umorena/Mastermind/README.md

# Mastermind
<h2>PROJET ARDUINO - MASTERMIND</h2>

Gubeno Manon - PeiP2 Groupe 2
Morena Ugo - PeiP2 Groupe 2

<h3>Description générale :</h3>

<b>Idée principale :</b> Reprendre le concept du jeu Mastermind sous une forme électronique à l’aide d’Arduino. 

Notre idée de base est d’avoir une caisse (en bois) laquelle laisserait apparaître l’interface du jeu (rubans de LED pour les combinaisons de couleur choisies par le jouer, signaux lumineux pour indiquer le nombre de bonnes et mauvaises réponses etc..)

**Caisse / Support :**

Version finale : en bois, avec plaques de PVC recouvrant les LEDS

La boîte laissera apparaître toutes les LEDS et les boutons de choix des couleurs
Ajout d’une petite trappe qui s’ouvre lorsque le joueur trouve la bonne combinaison de couleur pour laisser apparaître la solution de la partie.

Deux types de parties :

-	Solution choisie par un autre joueur (duo)
-	Solution déterminée aléatoirement (solo)
 
Deux types de mode de jeu :

-	Utilisation des boutons matériels situés sur la boîte
-	Choix des couleurs sur smartphone 

Lancement d’une nouvelle partie : Interrupteur (pour allumer le mastermind)
Choix du nombre de joueurs/type de parties : Interrupteur
Recommencer la partie : bouton matériel

### Sitographie : 

https://www.instructables.com/id/Mastermind-Game-w-Arduino-Uno/
https://forum.arduino.cc/index.php?topic=79978.0
https://www.instructables.com/id/Arduino-Mastermind-Box-Prototype/
