umorena/Mastermind/Rapports_Séances/Gubeno_Manon/Gubeno-5_rapport.pdf

MANON GUBENO
03/02/20

## MASTERMIND ARDUINO

RAPPORT DE SÉANCE : Semaine du 3 février

Objectif de la séance :

- Soudures LEDs

1 ) SOUDURE DES LEDS

La séance d’aujourd’hui a uniquement servi à continuer les soudures des bandes de LEDs. Notre projet est constitué de deux serpentins de LEDS (contenant chacun 48 LEDs) soit de 96 LEDs mise en « serpentins ». Pour avoir une telle organisation il a fallu souder entre elles les bandes de LEDs :

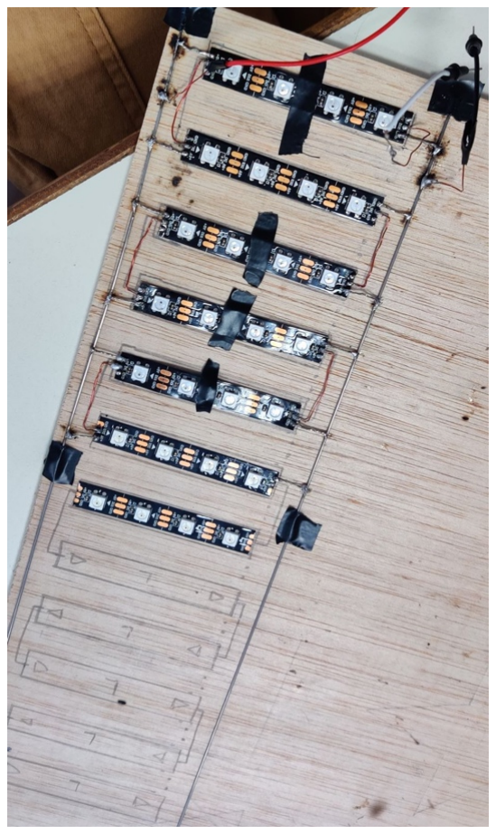
[picture p27: figure]
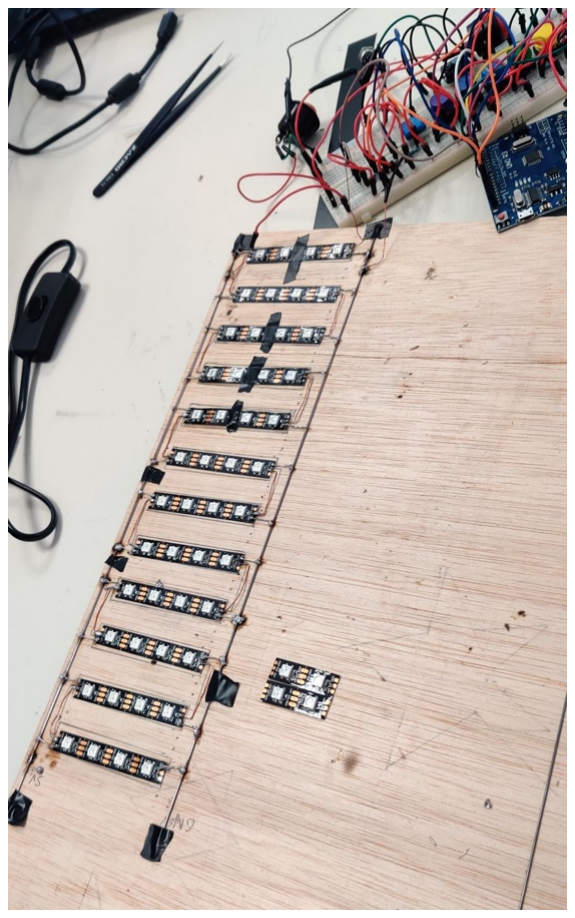
[picture p28: figure]

Le processus a pris beaucoup de temps car il fallait relier chaque bande de LEDs aux câbles 5V et GND, il fallait également relier toutes les bandes de LEDs entre elles.

A chaque bande rajouté il faut vérifier le bon fonctionnement de chacune des LEDs :

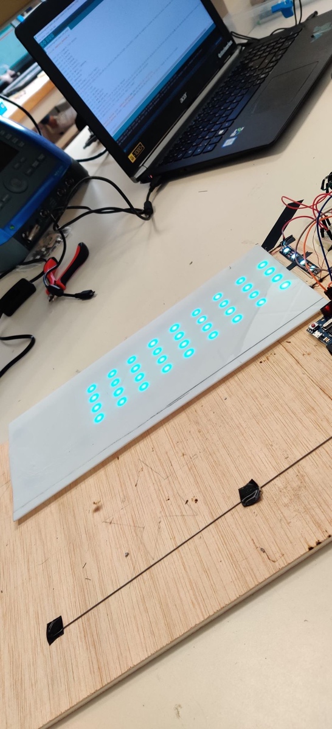
[picture p29: figure]
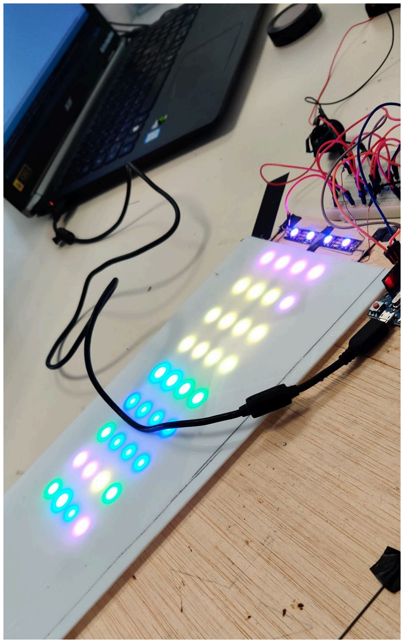
[picture p30: figure]
