umorena/Mastermind/Rapports_Séances/Gubeno_Manon/Gubeno-4_rapport.pdf

MANON GUBENO
13/01/20

## MASTERMIND ARDUINO

RAPPORT DE SÉANCE : Semaine de 13 janvier 2020

Objectif de la séance :

- Soudure LEDs
- ServoMoteur

1 ) SOUDURE LEDS

Notre projet est composé essentiellement de LED (en tout : (4*12)+(4*12)+4 = 100 LEDs) Pour minimiser les branchements et l’utilisation des ports on utilise des rubans de LEDs Neopixels.
On réalise deux serpentins de LEDs : pour se faire on doit souder des portions de LEDs et tester les raccords à chaque soudure réalisée.

Le processus est assez long car après chaque soudure on doit vérifier que tout fonctionne bien. On utilise le programme pour tester les lumières RGB de chaque LEDs et on l’applique à chaque bout de bande de LEDs soudé.

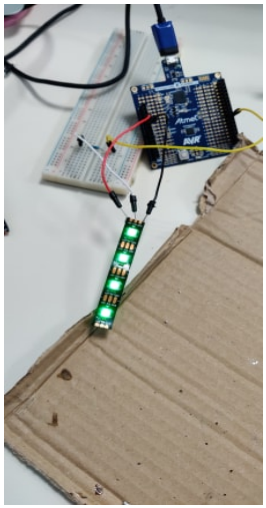
[picture p31: figure]
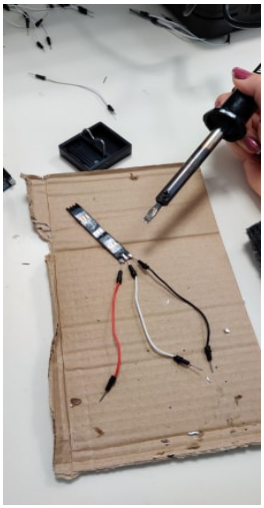
[picture p32: figure]

2) SERVOMOTEUR

Pour ouvrir la trappe qui dévoile la solution finale, on cherchait un moteur qui puisse se déclencher lorsque l’utilisateur trouvait la bonne réponse ou bien en cas d’échec.
Pour cela on utilise un ServoMoteur. Puisque c’était la première fois que j’utilisais un Servo moteur j’ai du chercher des tutoriels sur internet pour comprendre comment le brancher et comment le programmer.

Branchement du ServoMoteur :

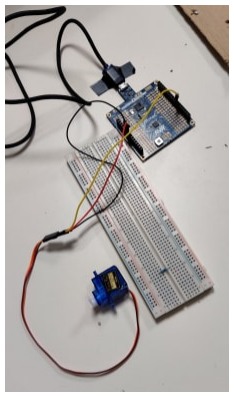
[picture p33: figure]
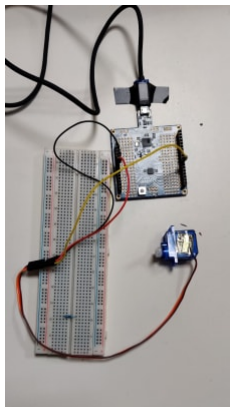
[picture p34: figure]

puis on réalise un code test pour vérifier qu’il fonctionne bien :

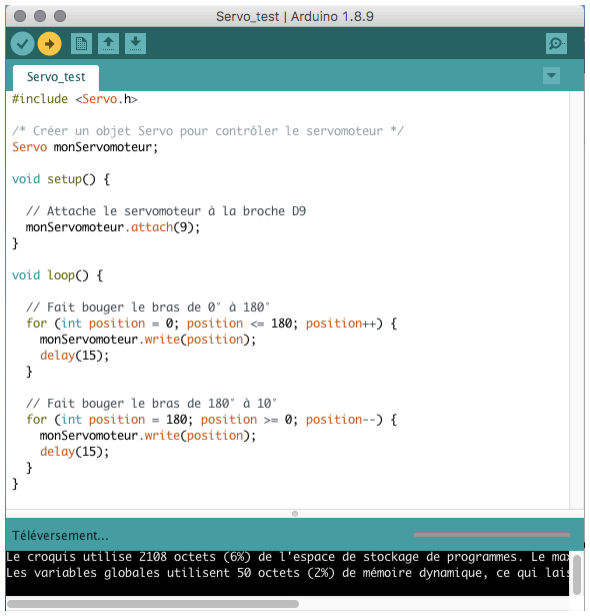
[picture p35: figure]

Le code permet au servomoteur d’effectuer des va-et-viens : on vérifie ainsi qu’il fonctionne bien.

On applique maintenant l’utilisation du servo-moteur à notre projet. Le but est d’effectuer un angle de 180° lorsque l’utilisateur trouve la bonne réponse ou lorsque la partie est finie.
