umorena/Mastermind/Rapports_Séances/Gubeno_Manon/Gubeno-2_rapport.pdf

MANON GUBENO
16/12/19

## MASTERMIND ARDUINO

RAPPORT DE SÉANCE : Semaine de 16 décembre

Objectif de la séance :

- Finir programme bande de LEDS
- Liaison bouton/LEDS

1 ) PROGRAMMER BANDES DE LEDS

À la dernière séance, j’ai essayé de comprendre comment fonctionnait les bandes LEDS et comment les programmer.
J’ai commencé par télécharger la bibliothèque FastLEDS et fais quelques tests peu concluants : seule la première LED s’allumait.

Solution possible : changer de bibliothèque ?

Après l’aide de Mr. MASSON, on télécharge la bibliothèque Adafruit_NeoPixel. On teste d’abord les LEDs pour être sûr qu’elles fonctionnent toutes avec un programme test (celui envoyé dans le mail de réponse) qui permet d’allumer toutes les LEDS dans les tons rouges, verts et enfin bleu afin de vérifier que toutes sont fonctionnelles et dans les trois teintes RGB

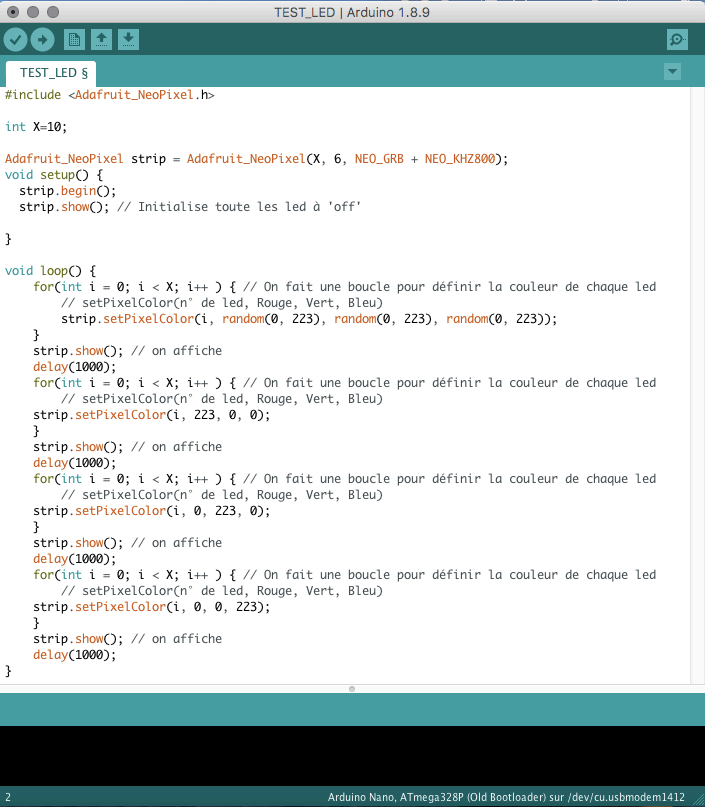
[picture p48: figure]

On utilise le programme pour tester les différentes bandes de LEDs que l’on a récupéré pour notre projet :

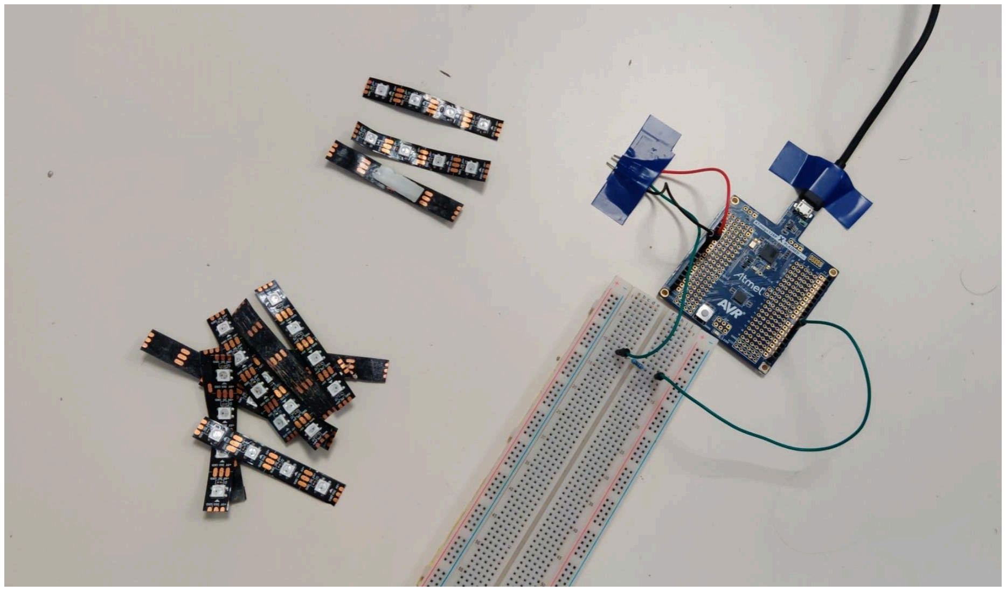
[picture p49: figure]

On vérifie que toutes les LEDs s’allument et que leur couleurs RGB ressortent bien :

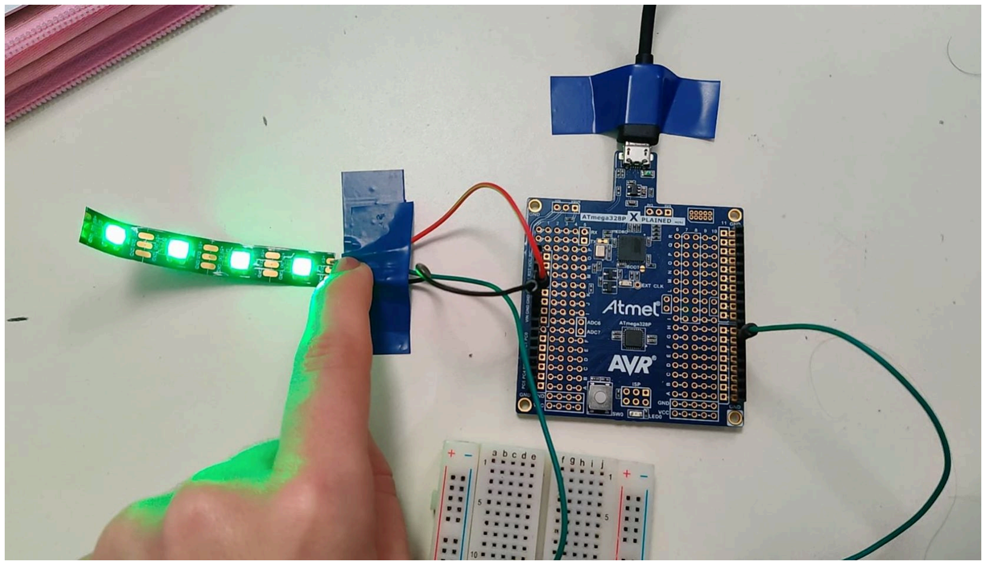
[picture p50: figure]
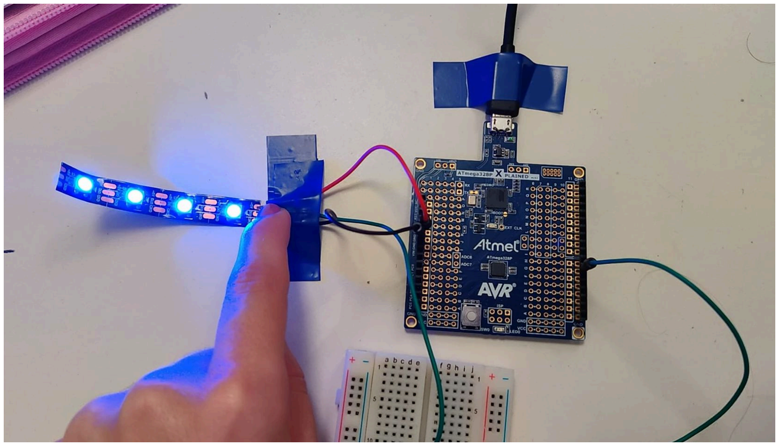
[picture p51: figure]
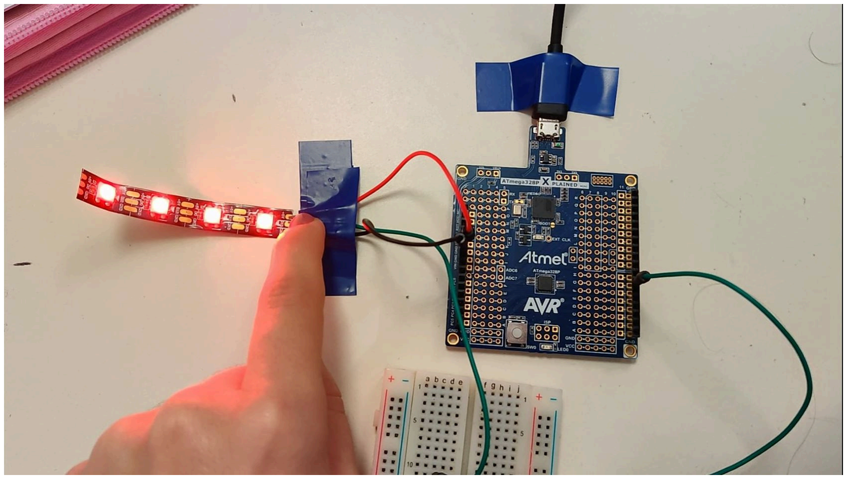
[picture p52: figure]

Après avoir vérifié le fonctionnement de chacune des LEDs, on réalise un code test permettant de tester l’allumage des LEDS dans des couleurs deux à deux différentes : (test réalisé sur des bandes de 4 LEDs)

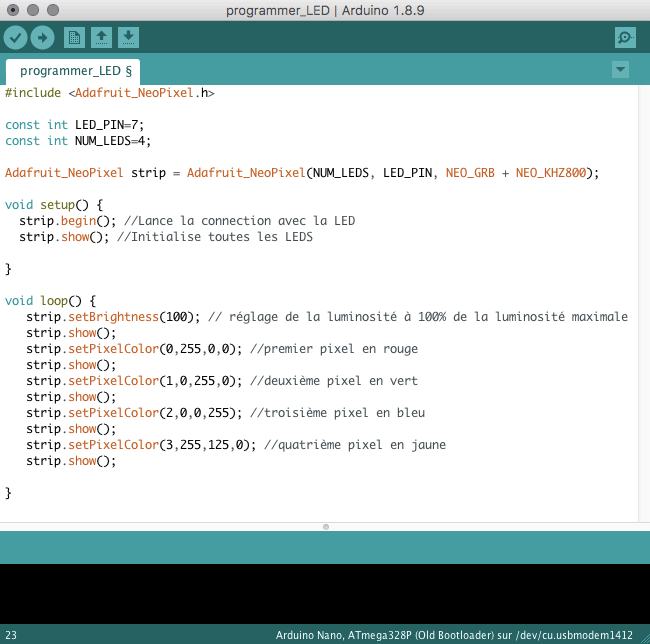
[picture p53: figure]
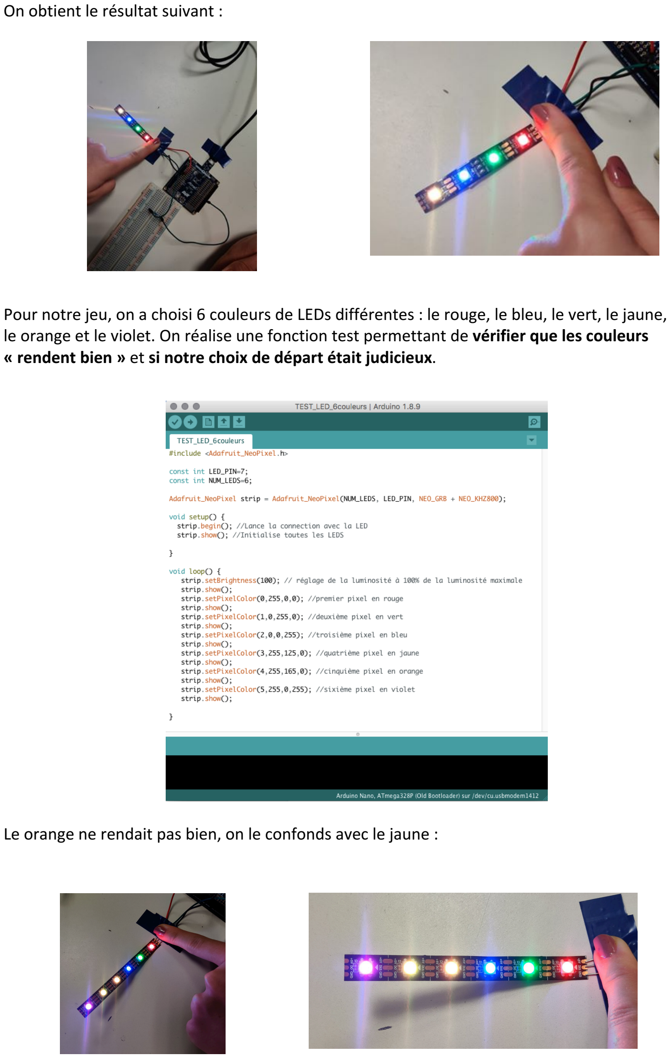
[picture p54: page 3]

On obtient le résultat suivant :

Pour notre jeu, on a choisi 6 couleurs de LEDs différentes : le rouge, le bleu, le vert, le jaune, le orange et le violet. On réalise une fonction test permettant de vérifier que les couleurs « rendent bien » et si notre choix de départ était judicieux.

Le orange ne rendait pas bien, on le confonds avec le jaune :

On réalise plusieurs test :

- Le rose → se confond avec le violet
- Le marron → se confond avec le rouge
- Le turquoise ✓

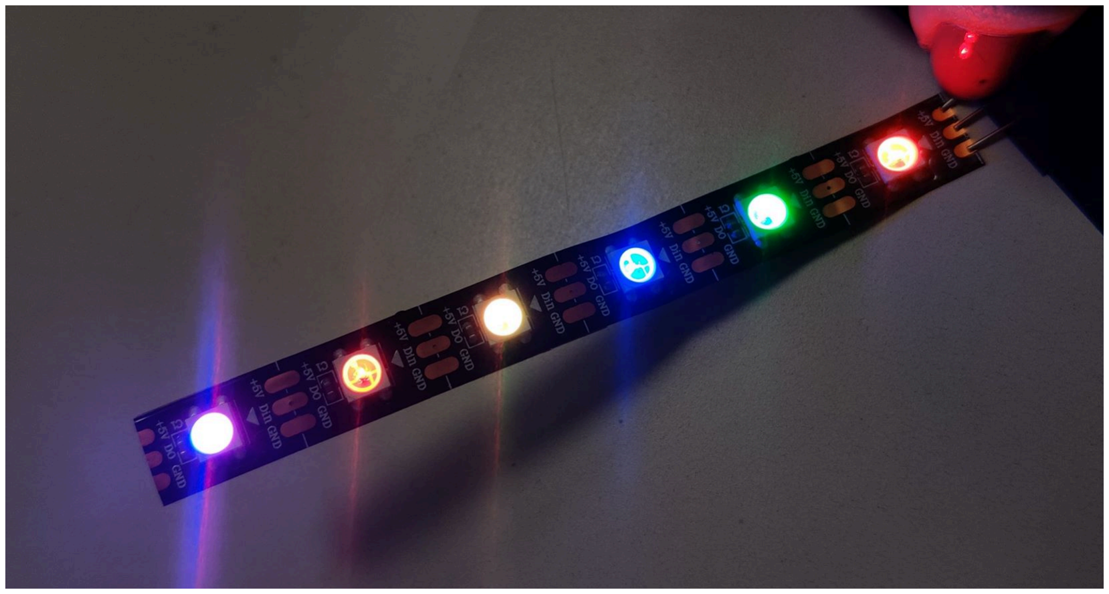
[picture p55: figure]
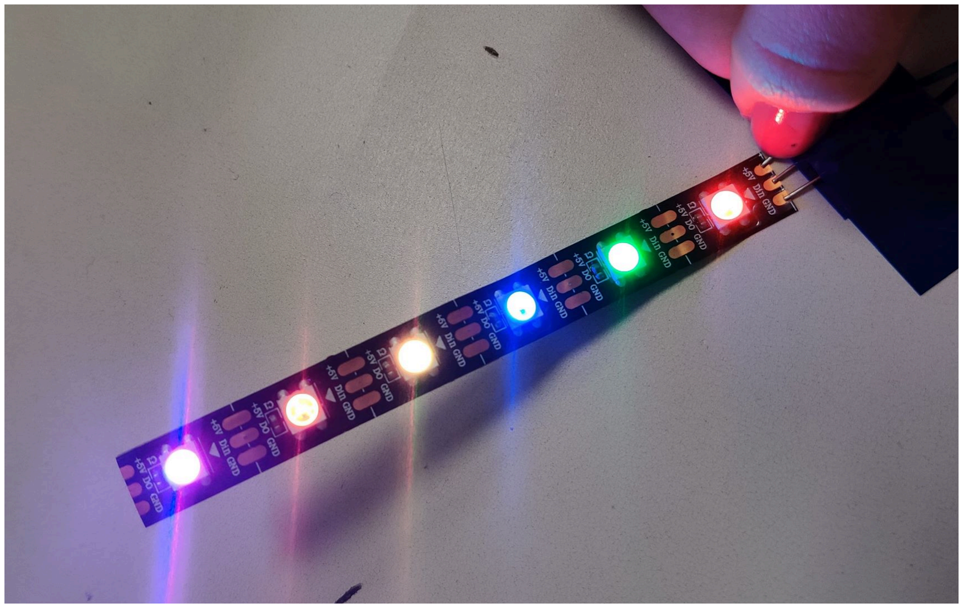
[picture p56: figure]
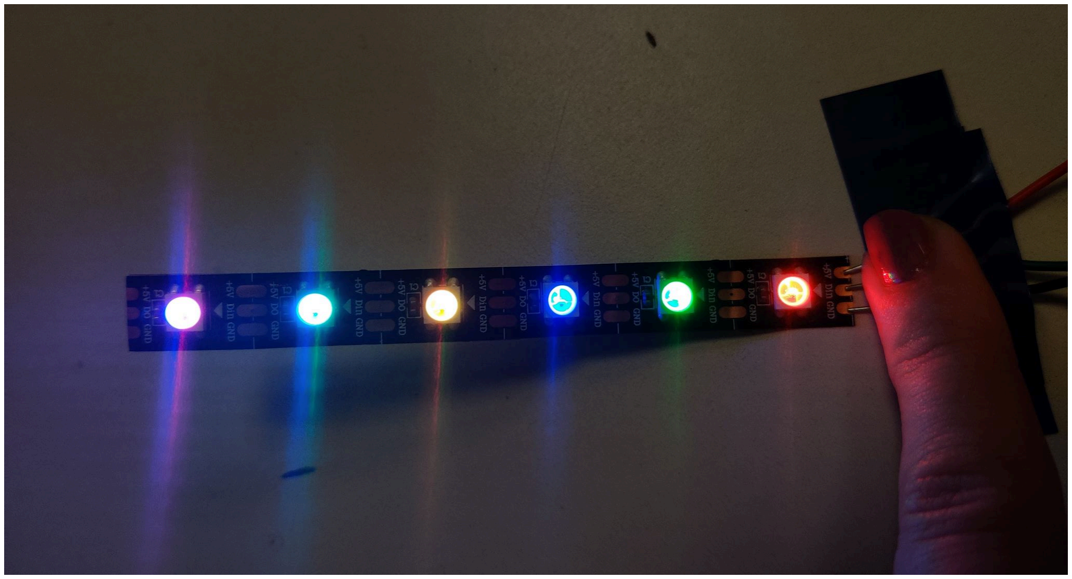
[picture p57: figure]

2) LIAISON BOUTON/LEDS

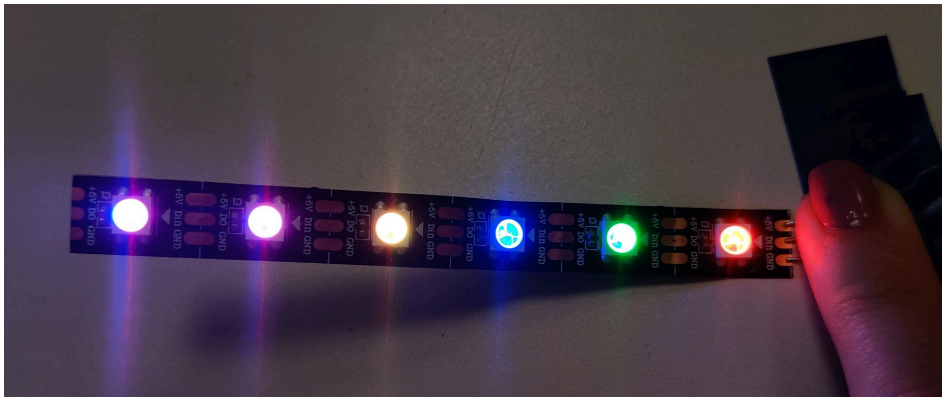
[picture p58: figure]
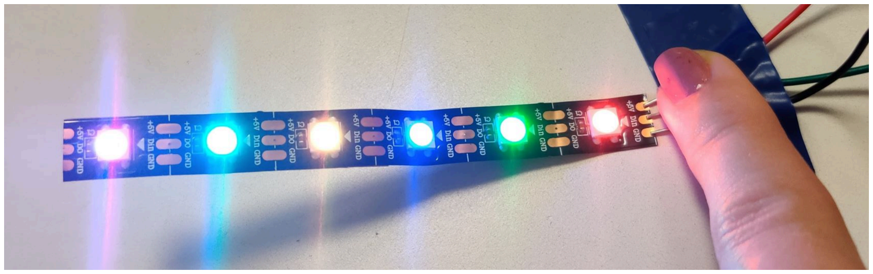
[picture p59: figure]

On cherche maintenant à lier l’action du bouton avec l’allumage des LEDs.
On a à notre disposition 6 boutons de couleurs, le but est :

Lorsque l’utilisateur appuie sur le bouton rouge, la première LED s’allume en rouge,
S’il appuie ensuite sur le bouton vert, la deuxième LED s’allume en vert (tout en conservant la première LED colorée en rouge),
S’il appuie ensuite sur le bouton vert, la troisième LED s’allume en violet (tout en conservant la couleur des 2 premières LEDs),
etc..

Au bout de la 4ème LED (extremité d’une ligne), le premier essai est terminé et il passe au second → première LED de la deuxième ligne

Et ainsi de suite !

Simulation pour essayer d’appréhender au mieux le programme à écrire : (l’éclair représente l’action d’appuyer sur un bouton)

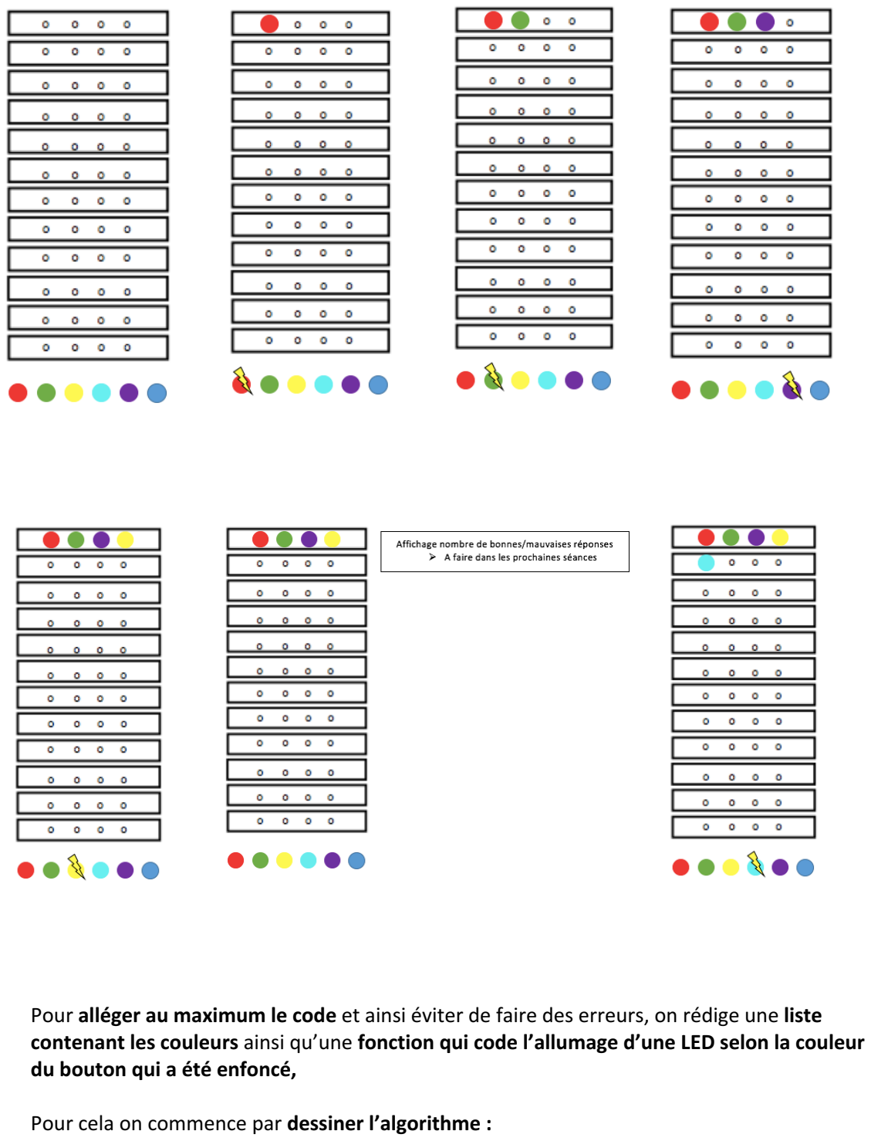
[picture p60: page 5]

Pour alléger au maximum le code et ainsi éviter de faire des erreurs, on rédige une liste contenant les couleurs ainsi qu’une fonction qui code l’allumage d’une LED selon la couleur du bouton qui a été enfoncé,

Pour cela on commence par dessiner l’algorithme :

La couleur d'une LED se définit sous 4 variables :

- sa position sur la bande (de 0 à 48)
- son pourcentage en rouge
- son pourcentage en vert
- son pourcentage de bleu

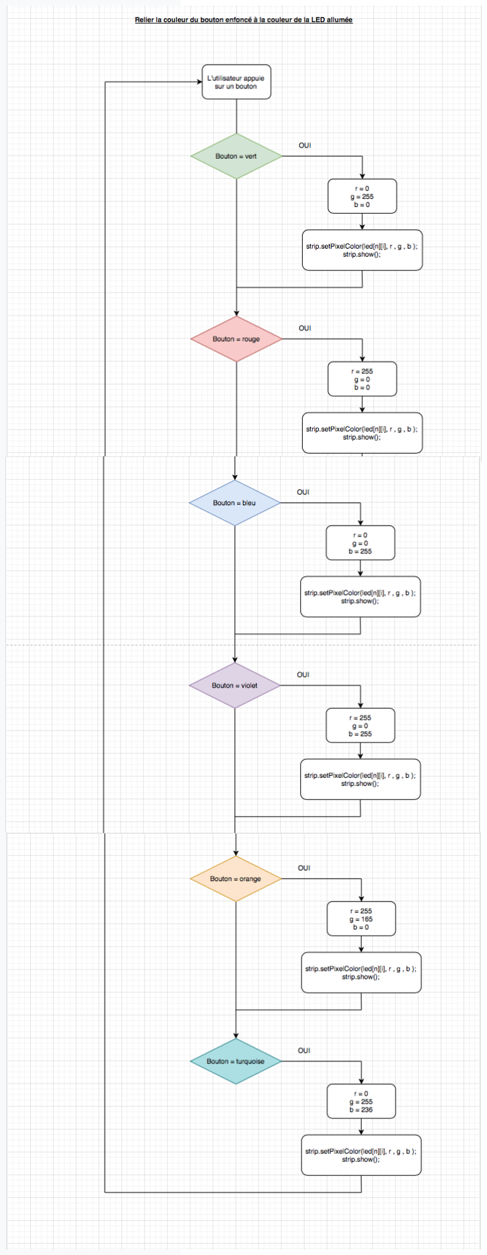
[picture p61: figure]
