umorena/Mastermind/Rapports_Séances/Morena_Ugo/Morena-8_rapport.pdf

Ugo Morena G2
RAPPORT SÉANCE 2 MARS 2020

Objectif de la séance :

- Fignoler des détails de code
- Continuer l'assemblage de la boite
- Avancer / finir le bluetooth (avec Manon)

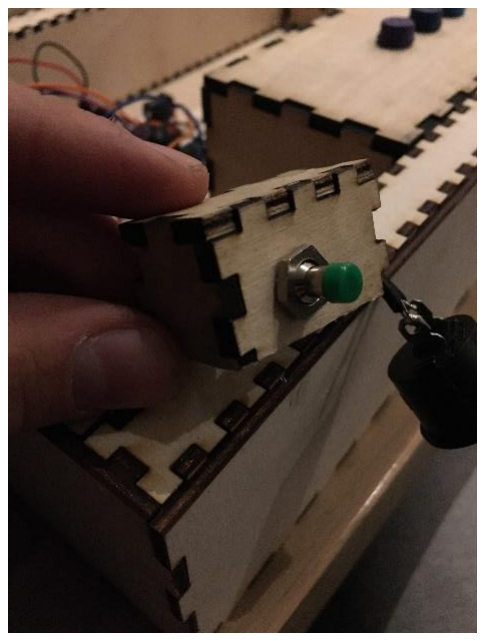
[picture p97: figure]
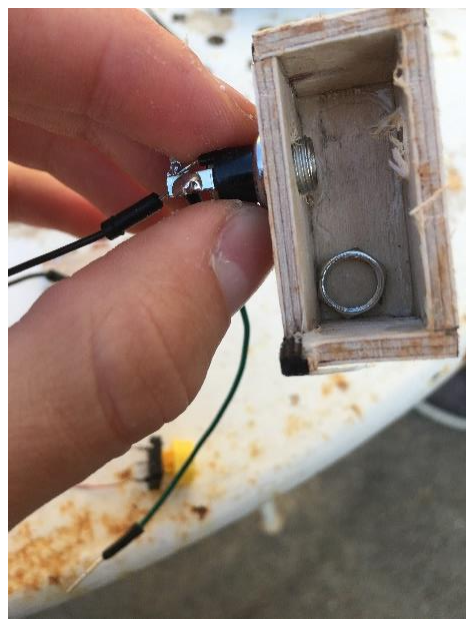
[picture p98: figure]

Travail réalisé avant la séance :

Avancement de la boîte en bois :

Idée de base pour l'attache des boutons

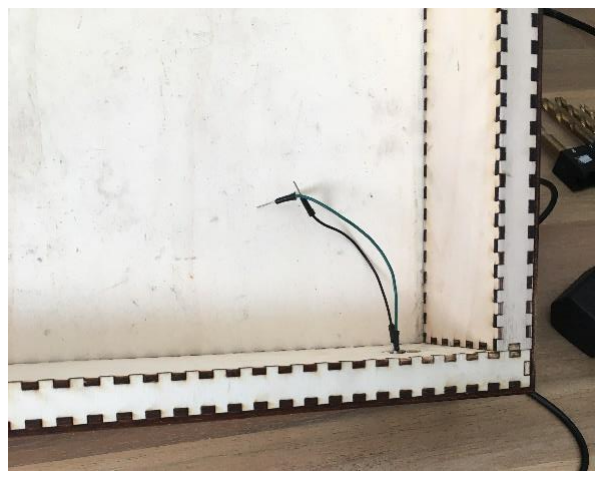
[picture p99: figure]
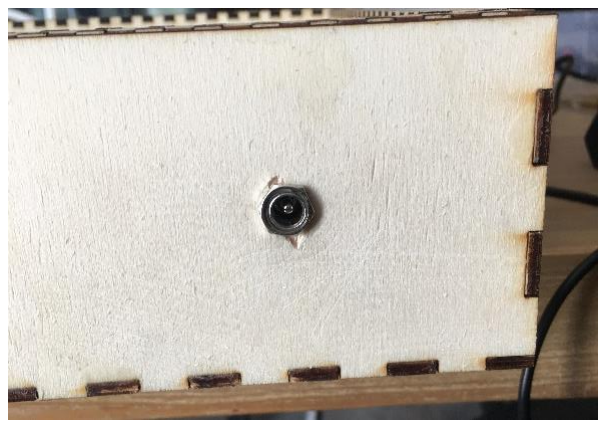
[picture p100: figure]
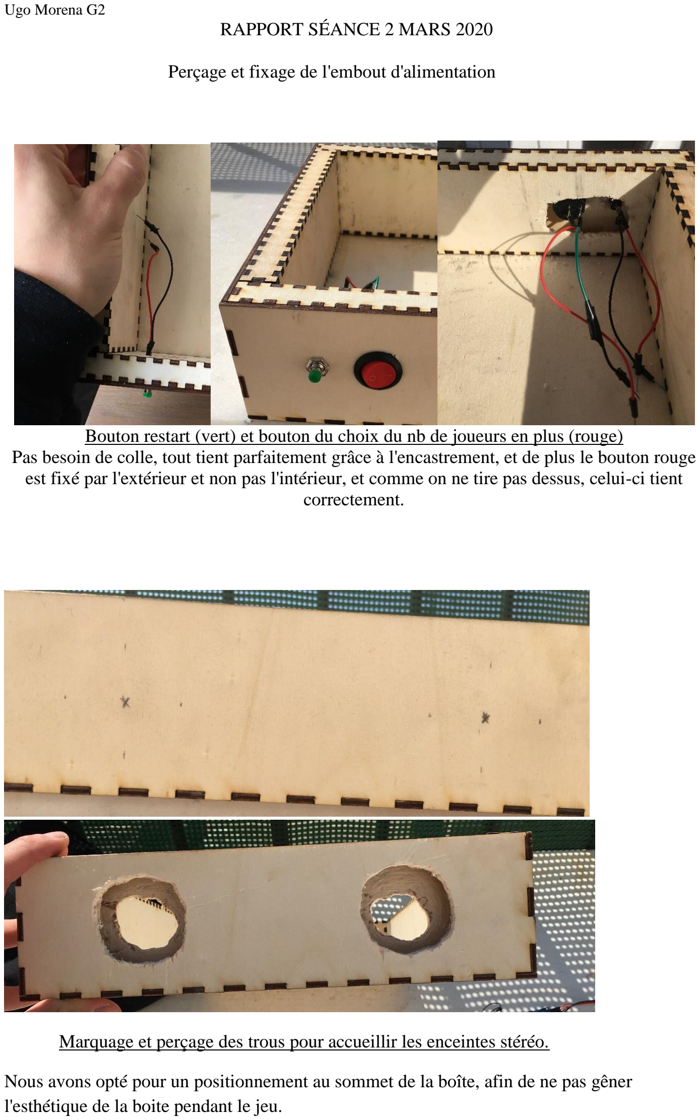
[picture p101: page 2]

Perçage et fixage de l'embout d'alimentation

Bouton restart (vert) et bouton du choix du nb de joueurs en plus (rouge)
Pas besoin de colle, tout tient parfaitement grâce à l'encastrement, et de plus le bouton rouge est fixé par l'extérieur et non pas l'intérieur, et comme on ne tire pas dessus, celui-ci tient correctement.

Marquage et perçage des trous pour accueillir les enceintes stéréo.

Nous avons opté pour un positionnement au sommet de la boîte, afin de ne pas gêner l'esthétique de la boite pendant le jeu.

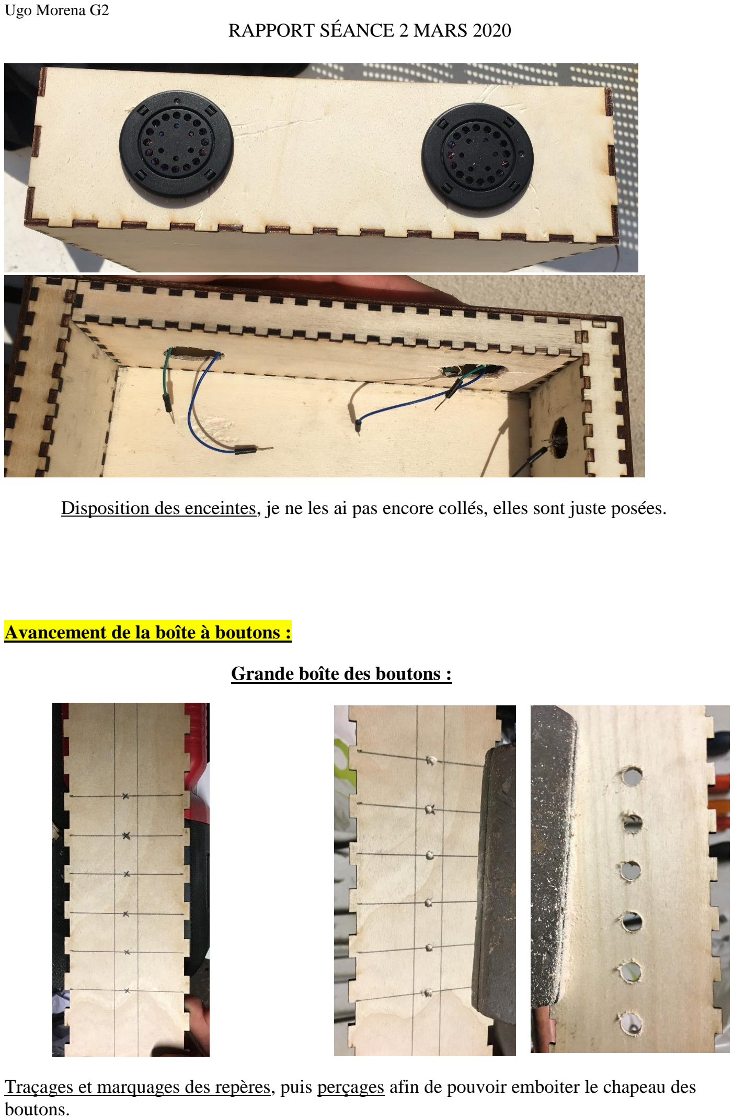
[picture p102: page 3]

Disposition des enceintes, je ne les ai pas encore collés, elles sont juste posées.

Avancement de la boîte à boutons :

Grande boîte des boutons :

Traçages et marquages des repères, puis perçages afin de pouvoir emboiter le chapeau des boutons.

Petite boîte des boutons :

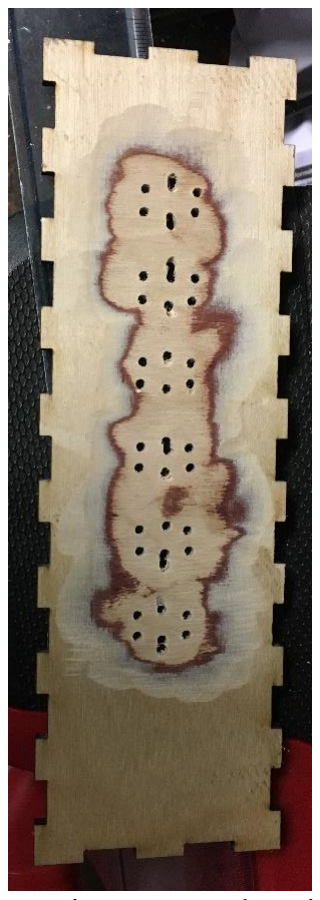
[picture p103: figure]
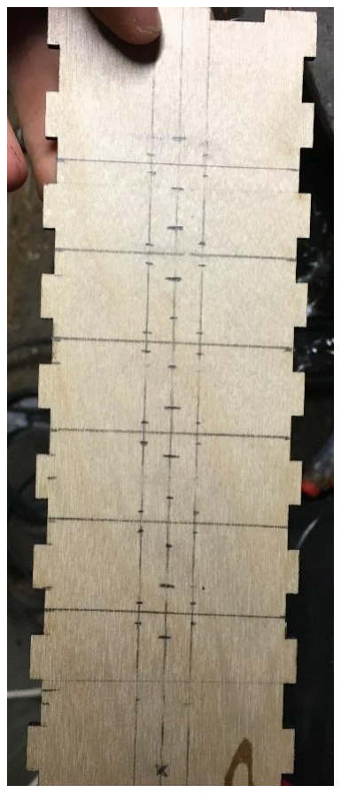
[picture p104: figure]

Traçage et marquage des repères, puis perçages pour venir encastrer les pins des boutons Enfin, ponçage afin de réduire l'épaisseur et permettre un écart plus faible pour que les boutons puissent être correctement pressés.

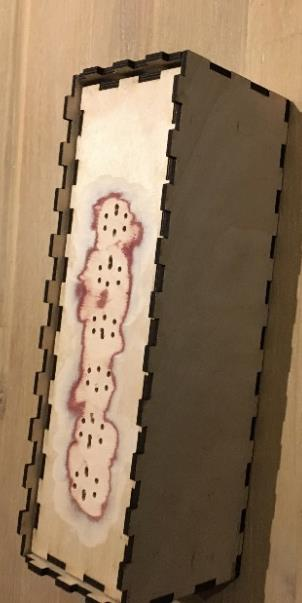
[picture p105: figure]
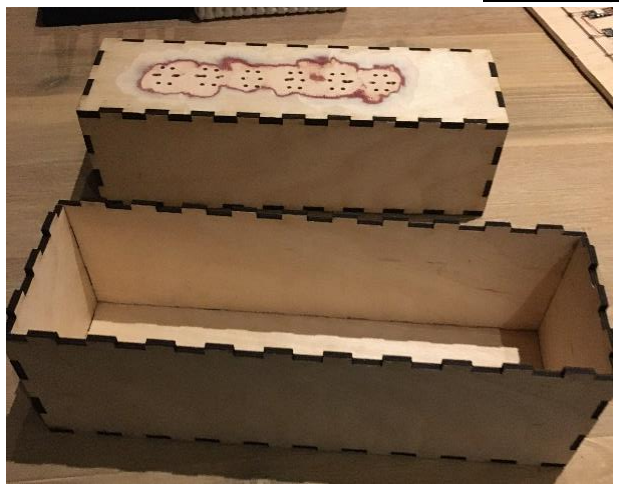
[picture p106: figure]

Assemblage :

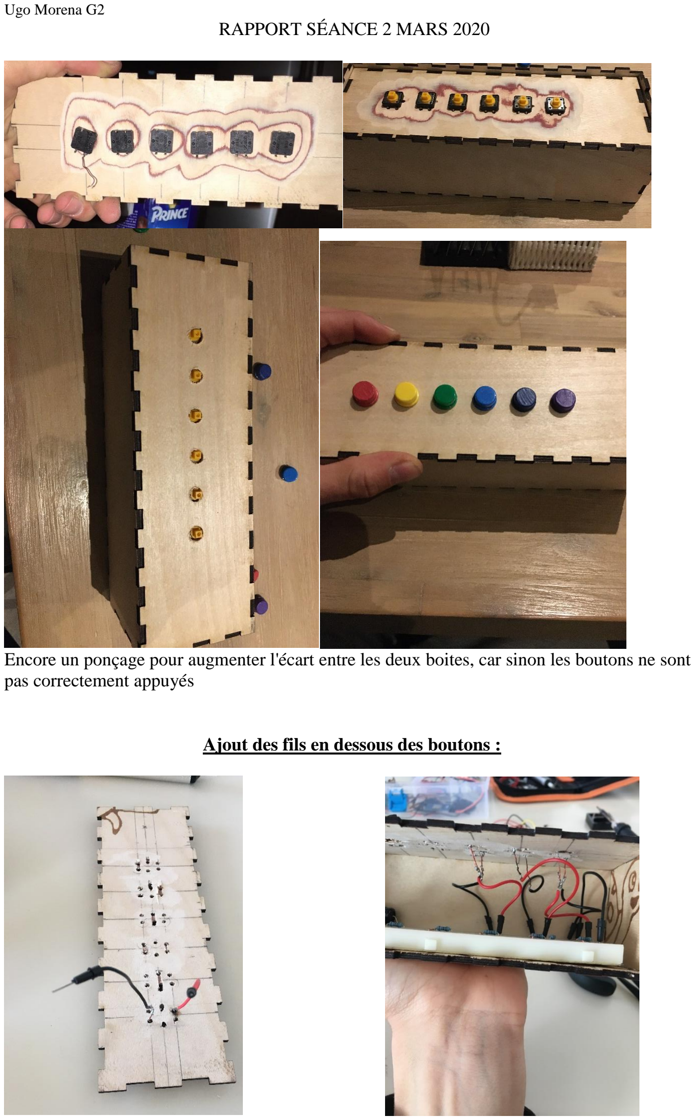
[picture p107: page 5]

Encore un ponçage pour augmenter l'écart entre les deux boites, car sinon les boutons ne sont pas correctement appuyés

Ajout des fils en dessous des boutons :

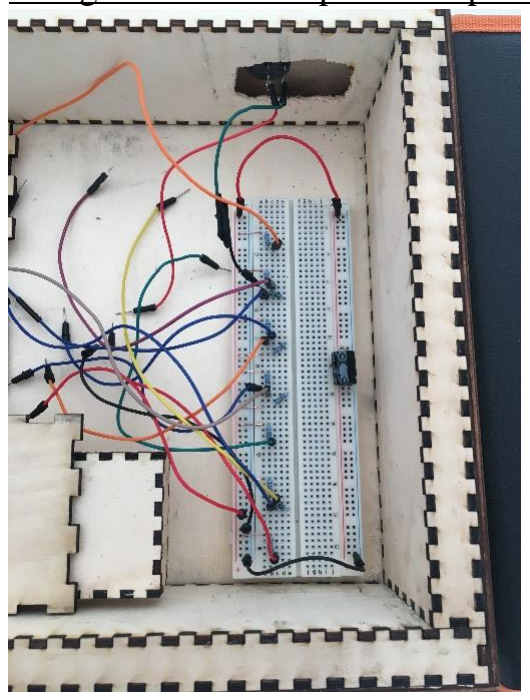
[picture p108: figure]

Réorganisation de la planche à pain, et traçage des traits de découpe sur les faces de la boite.

Travail réalisé durant la séance :

J'ai changé le bouton restart et undo car ceux-ci s'étaient cassés. Ensuite, j'ai continué les soudures pour les câblages des boutons, ce qui m'a pris un certain temps.
J'ai inséré la boite des boutons dans la boite du Mastermind, pour pouvoir ensuite brancher la planche au reste de l'arduino, ce qui est très minutieux.

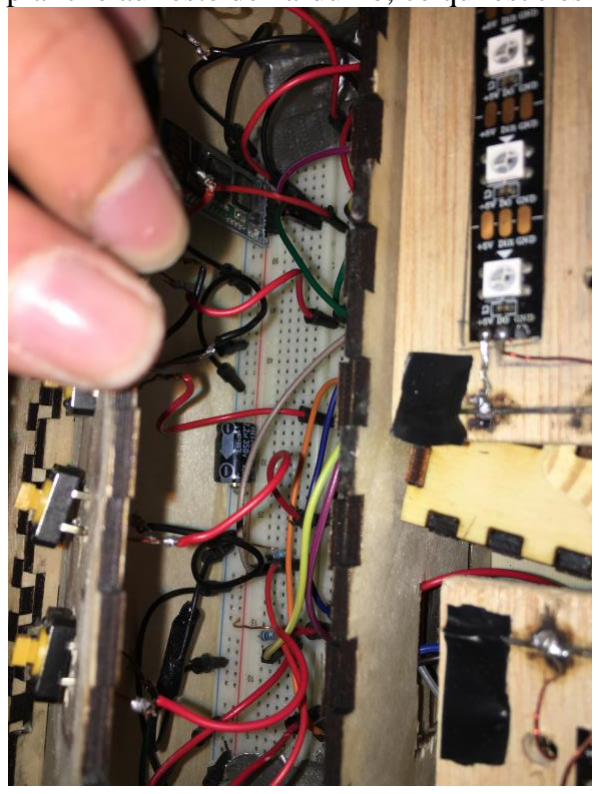
[picture p109: figure]

Vue de l'intérieur !

Il a fallu ressouder quelques fils car ils se sont défaits à force de les tirer...
J'ai également collé à la boite les enceintes et le bouton retour sur la boite des boutons.

Au fablab, nous avons fait les boites, et nous en avons collés quelques-unes.
J'ai percé la boite de la trappe afin de faire passer les fils des haut-parleurs et de l'alimentation du Mastermind :

Comme vous pouvez le voir nous avons fait graver Mastermind sur la trappe.
Nous avons eus des soucis avec la découpe des boites car l'appareil ne nous donnait pas les dimensions désirées... Mais nous nous sommes adaptés et trouvé une solution qui semble convenir !

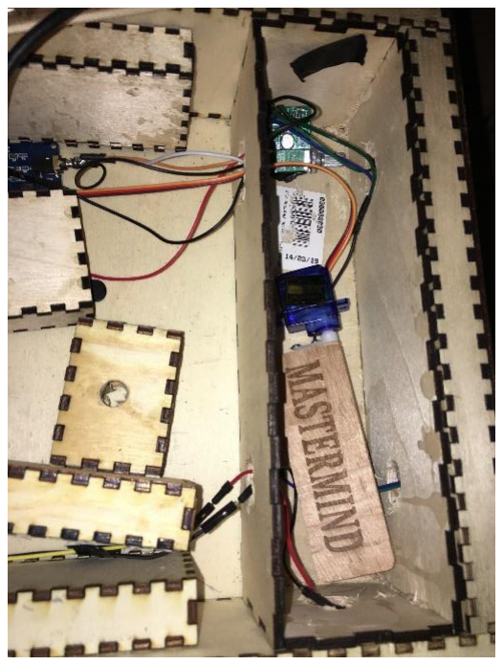
[picture p110: figure]

J'ai actuellement un petit souci de code, nous allons voir ça avec Manon pour étudier le fonctionnement avec le bluetooth, mais certaines cdt ne se font pas à cause des cdts mises en place pour le bluetooth.
Idem, un autre souci, quand je change le nb de joueurs la partie ne recommence pas... trouvé ! après étude du code, j'avais mis dans la fct restart que celle-ci ne se faisait uniquement si l'on appuyait sur le bouton restart, je ne dois pas mettre ça vu que c'est déjà dans le main...

Il ne me reste plus qu'à régler ce problème de musique... Je ne trouve pas encore la solution. Enfin réussi, j'ai remis les branchements correctement. Néanmoins j'ai quand même un petit bruit de fond strident quand le son est plus élevé et de plus, celui-ci augmente proportionellement au nombre de LEDS allumées.
Bref, le jeu est jouable ! Toutes les fonctions marchent, alleluia.
Il ne me manque plus que la finalisation de la boite et le bluetooth... affaire à suivre Lundi prochain devant vous, depuis le temps que vous attendez ! Je ne vous mets pas encore de démo pour garder le suspens haha (je ferai une vidéo au cas où ça marche plus lol)

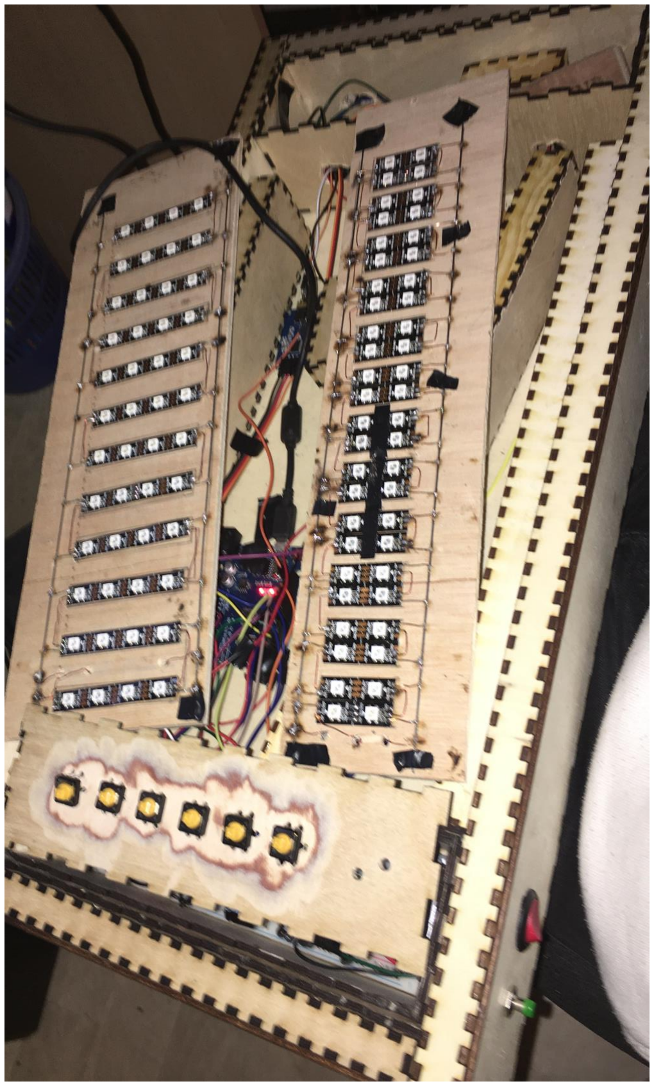
[picture p111: figure]

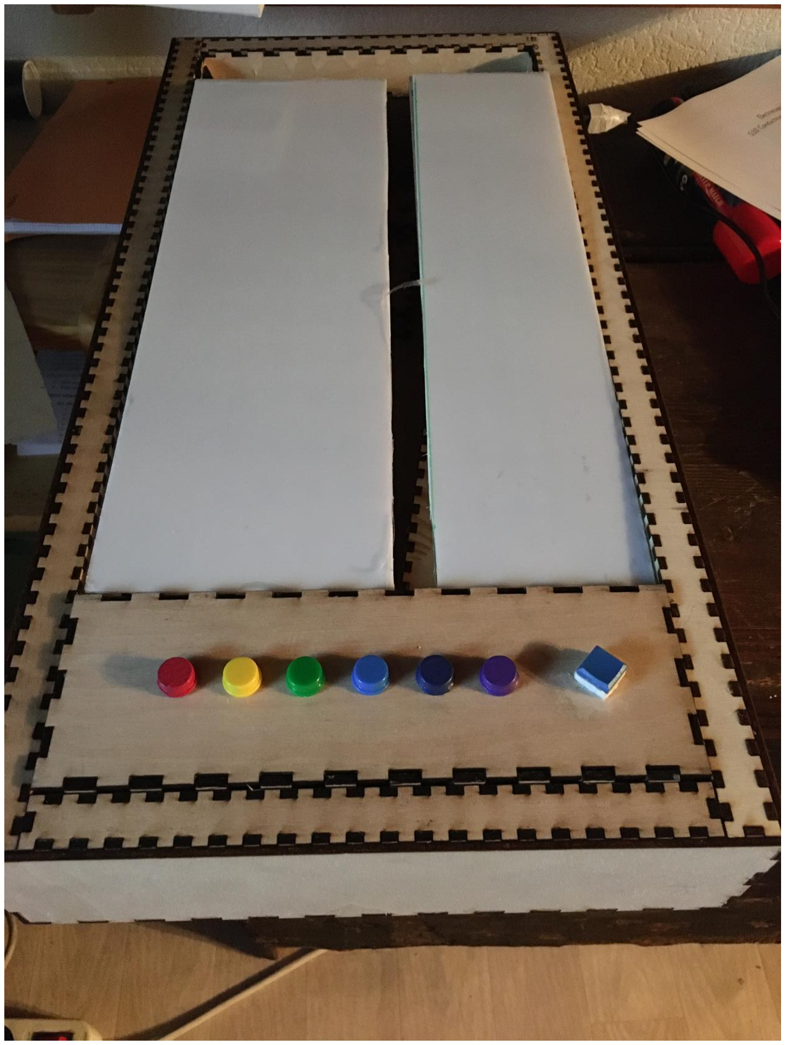
[picture p112: figure]

Il manque des parties !
