umorena/Mastermind/Rapports_Séances/Morena_Ugo/Morena-7_rapport.pdf

Ugo Morena G2
RAPPORT SÉANCE 17 FEVRIER 2020

Objectif de la séance :

- Couper les planches de plexiglass pour les poser au-dessus des LEDS
- Couper les planches de bois des LEDS
- Gérer la musique du jeu (à continuer dans la semaine)
- Fixer quelques paramètres du jeu pour l’améliorer (dont la génération aléatoire de la solution

Vendredi 14/02 nous sommes allés au FabLab pour commencer notre boîte ! Je vous laisse regarder le rapport de Manon pour le détail des opérations effectuées. Prochain rdv le 21/02 pour découper les dernières boîtes manquantes.

Voici quelques rendus de la découpe des plaques de plexi :

Nous avions besoin d’une planche en plexi de taille 35x11 et une autre de taille 35x8.

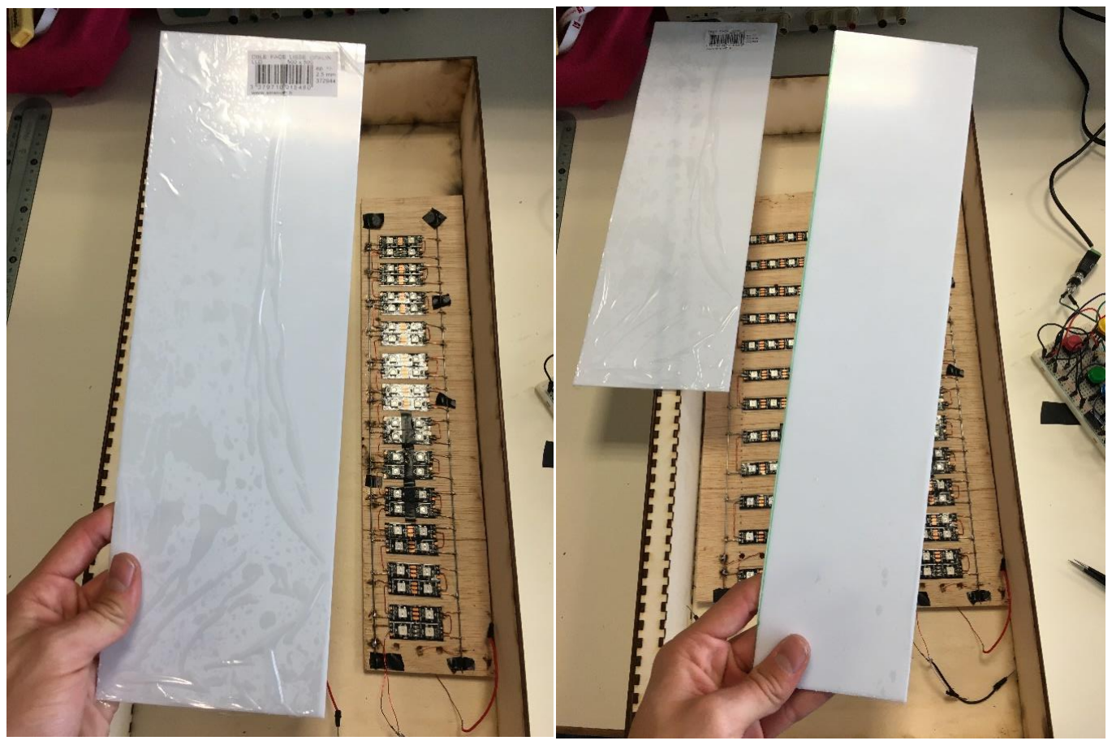
[picture p113: figure]

Et des planches à LEDS, trouées afin de faire passer les fils en dessous.

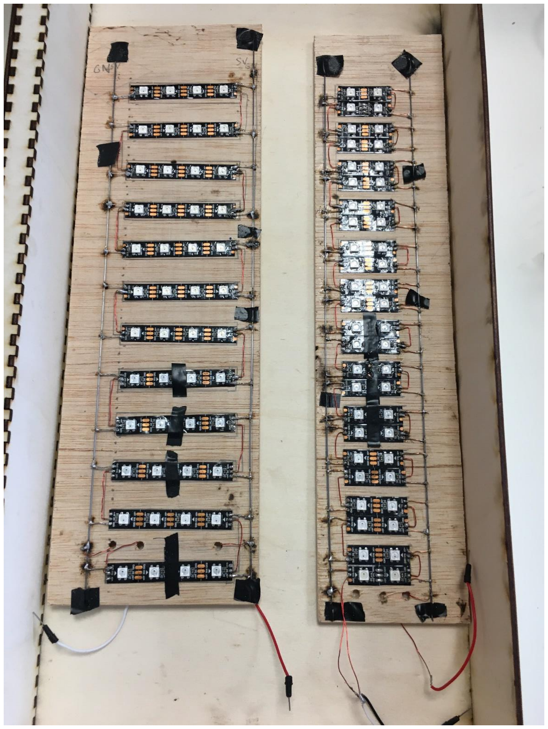
[picture p114: figure]

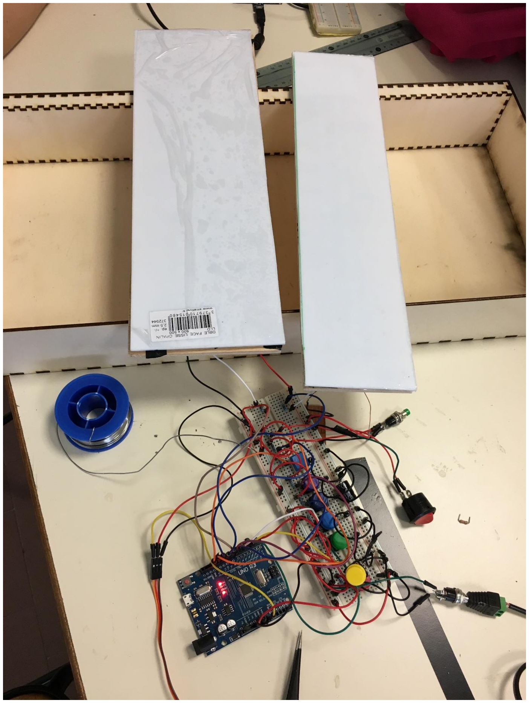
[picture p115: figure]

Petite photo du jeu branché !

Idées des musiques à mettre :

WIN

++Default : https://www.youtube.com/watch?v=Kp4Um4AS-5U

++Final fantasy : https://www.youtube.com/watch?v=-YCNa0NsNk&list=PLw9AcE2IomDNjCTqiXGAv7COU0WB14LYO&index=2 (https://www.youtube.com/watch?v=-YCN-a0NsNk&list=PLw9AcE2IomDNjCTqiXGAv7COU0WB14LYO&index=2)

++Mario Kart :
https://www.youtube.com/watch?v=Zcp0WHWhYVM&list=PLw9AcE2IomDNjCTqiXGAv7COU0WB14LYO&index=14 (https://www.youtube.com/watch?v=Zcp0WHWhYVM&list=PLw9AcE2IomDNjCTqiXGAv7COU0WB14LYO&index=14)

++Bomber Man : https://www.youtube.com/watch?v=ggHecbCJsw&list=PLw9AcE2IomDNjCTqiXGAv7COU0WB14LYO&index=18 (https://www.youtube.com/watch?v=ggHecbCJ-sw&list=PLw9AcE2IomDNjCTqiXGAv7COU0WB14LYO&index=18)

--Pokemon : https://www.youtube.com/watch?v=e7zMbX_0e5o

--Premier coup : https://www.youtube.com/watch?v=WPzMxiGd0io

LOOSE

--Mario :
https://www.youtube.com/watch?v=0WVyszWsPjg&list=PLIzvv_yKP_jxgjqU6lqRCb7cbLCVt9c9S&index=7

++Pouin pouin puin : https://www.youtube.com/watch?v=jAIlKqL3nHo

--Mr chicken parodie : https://www.youtube.com/watch?v=uDrdZM1iGrc

--GTA :
https://www.youtube.com/watch?v=OleLlIpymtU&list=PLppsEWZrWpltCEJBeuobhjx1o496 ssXmd

++Mario dead :
https://www.youtube.com/watch?v=hom9faSBUHQ&list=PLppsEWZrWpltCEJBeuobhjx1o496ssXmd&index=3

--Whatcha say :
https://www.youtube.com/watch?v=KZm6UxrFdig&list=PLppsEWZrWpltCEJBeuobhjx1o496ssXmd&index=23

++End credits :
https://www.youtube.com/watch?v=Lm4LYX3xdkU&list=PLppsEWZrWpltCEJBeuobhjx1o496ssXmd&index=24 (https://www.youtube.com/watch?v=Lm4LYX3xdkU&list=PLppsEWZrWpltCEJBeuobhjx1o496ssXmd&index=24)

++Hello darkness my old friend : https://www.youtube.com/watch?v=qYS0EeaAUMw&list=PLppsEWZrWpltCEJBeuobhjx1o496ssXmd&index=25 (https://www.youtube.com/watch?v=qYS0EeaAUMw&list=PLppsEWZrWpltCEJBeuobhjx1o496ssXmd&index=25)

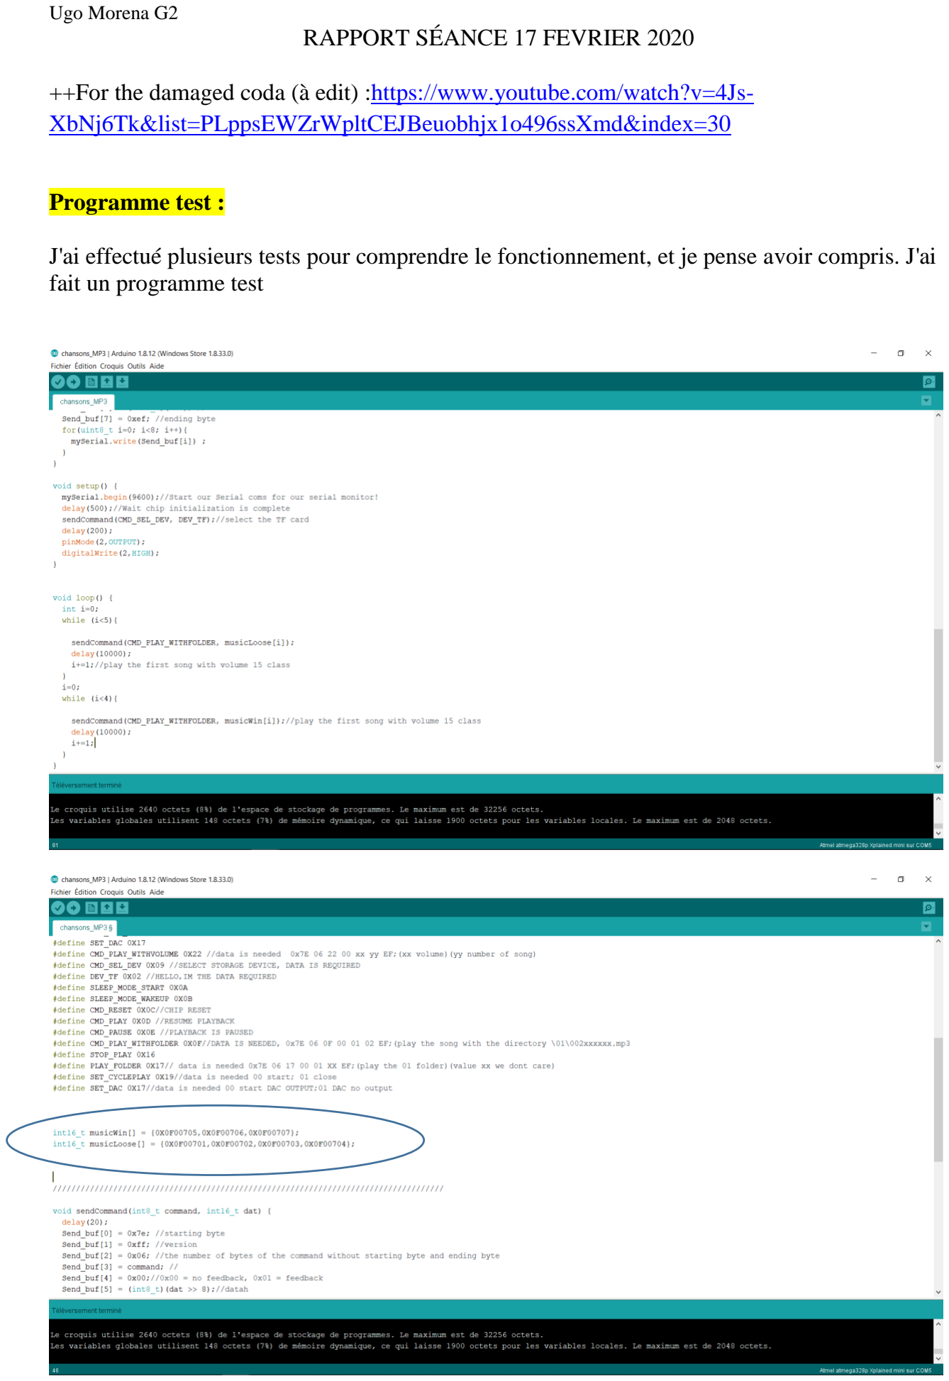
[picture p116: page 5]

++For the damaged coda (à edit) :https://www.youtube.com/watch?v=4Js-XbNj6Tk&list=PLppsEWZrWpltCEJBeuobhjx1o496ssXmd&index=30 (https://www.youtube.com/watch?v=4Js-XbNj6Tk&list=PLppsEWZrWpltCEJBeuobhjx1o496ssXmd&index=30)

Programme test :

J'ai effectué plusieurs tests pour comprendre le fonctionnement, et je pense avoir compris. J'ai fait un programme test

J'ai créé deux listes, comportant les musiques de victoire et défaite ! Je pourrai donc choisir aléatoirement parmi ces musiques à la fin du jeu. On pourra également (peut-être) ajouter la possibilité de choisir la musique voulu avec le téléphone en bluetooth.

Génération de la solution aléatoire :

Ce qui peut être fait en plus de choisir une solution aléatoire, c’est lire les variations sur une entrée analogique, et de réutiliser ces valeurs pour générer une solution aléatoire.
Je n'ai pas réussi à utiliser ce système j'aurai besoin de vous la semaine prochaine pour m'aider. Je continuerai dans la semaine.
