umorena/Mastermind/(commit log)

2019-12-10 Add files via upload
    Temporaire, il manque une partie du diagramme
2020-01-07 Add files via upload
    Travail réalisé pendant les vacances de noël + à la maison car j'étais absent au cours du Lundi 06/01/2020 (absence justifiée).
2020-01-07 Add files via upload
    Travail réalisé pendant les vacances de noël + à la maison pour remplacer la séance ratée du Lundi 06 Janvier 2020 (absence justifiée).
